Adem-O/OPTICA_MQ_LaserMaze/README.md

# OPTICA MQ Student Chapter - Laser Maze Project:
This repo contains the code and auxillary files for the MQ OPTICA Student Chapter laser maze.

Documentation on the setup and running of the laser maze can be found here: [PENDING]

The UI is run on the controller's Raspberry Pi using `LaserMazeController.py`. 
The schematic for the controller and Pi is found in `LaserMazeControllerSchematic.pdf`.

The associated i2c commands are stored in `opticamqfunclib.py`.

The arduinos which run the detectors and laser diodes have the `main_V8.ino` code saved to memory, this allows them to excute control functions on request (sent from the Pi via i2c). 
The schematic for the detector and arduino modules are found in  `LaserMazeDetectorsSchematic.pdf`
The encolsure schematics for the detectors is found in `LaserMaze_Detector_Enclosure.pdf`

## Credit <br>
**Enclosures and Design/Concept:** Dr Simon Gross, Associate Professor Faculty of Science and Engineering, Macquarie University<br> <br>
**Software Contributors:** Alan Tricoche ( Université Paris-Saclay), Elizabeth Arcadi (Macquarie University), James Bainbridge (Macquarie University), Adem Ozer (Macquarie University)<br> <br>
**Schematics Designed by:** Dr Russell Connally, Logic Systems Design <br> <br>

For any questions about the code/setup feel free to email: adem.ozer@hdr.mq.edu.au
