Adem-O/OPTICA_MQ_LaserMaze/LaserMazeDetectorsSchematic.pdf

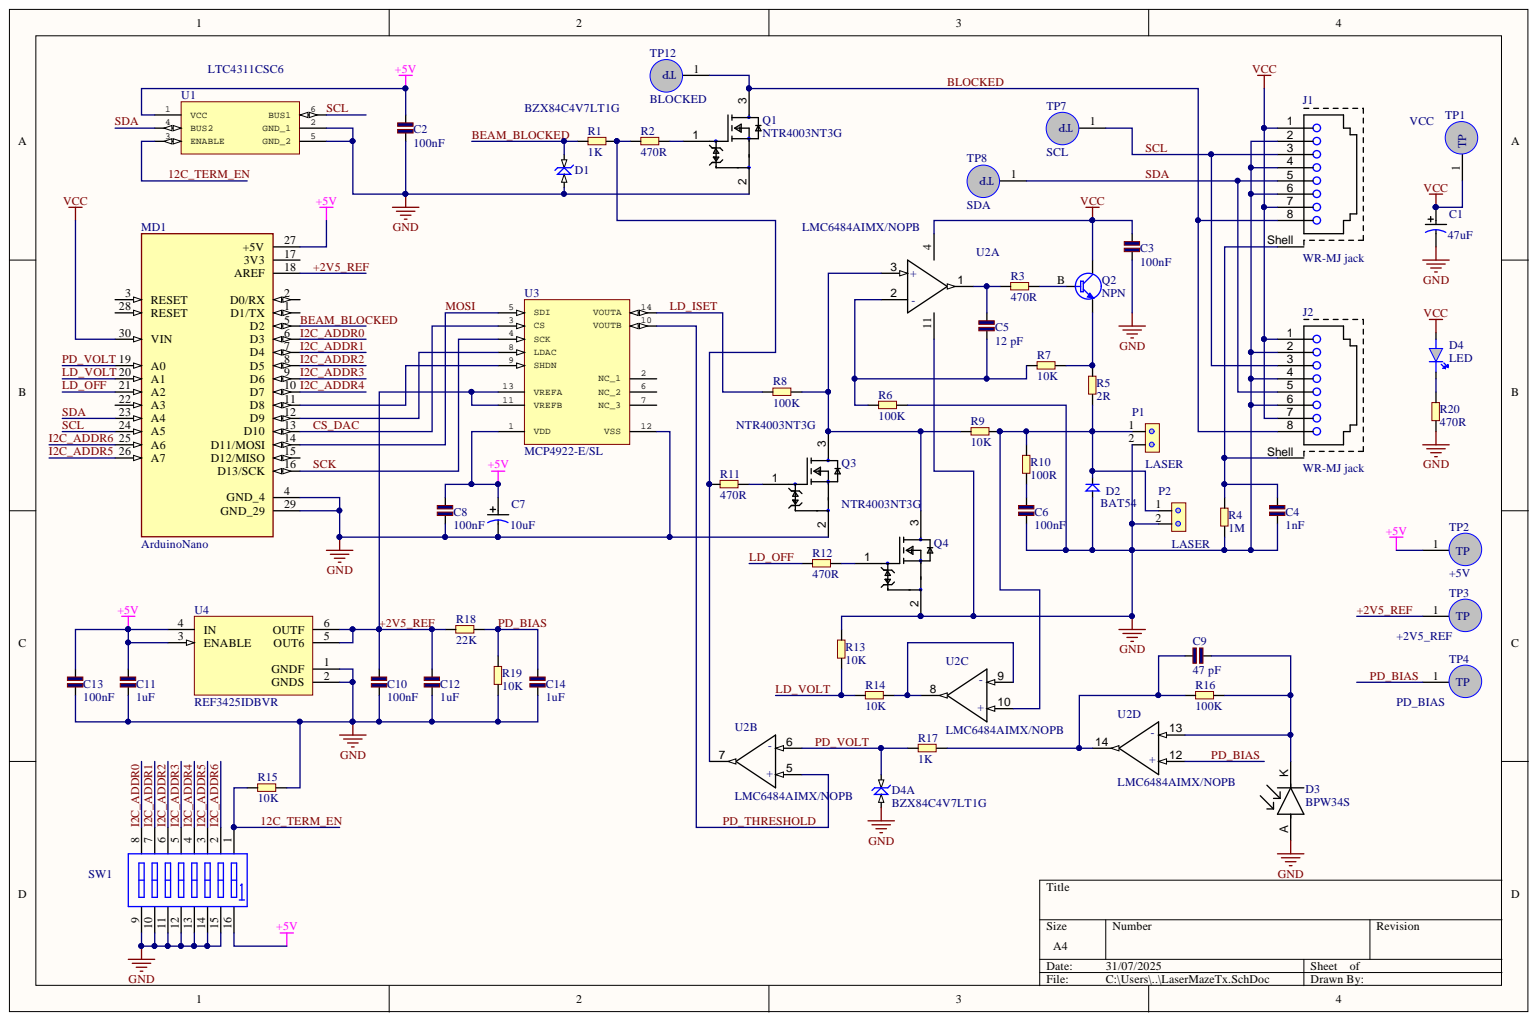
[picture p4: page 1]

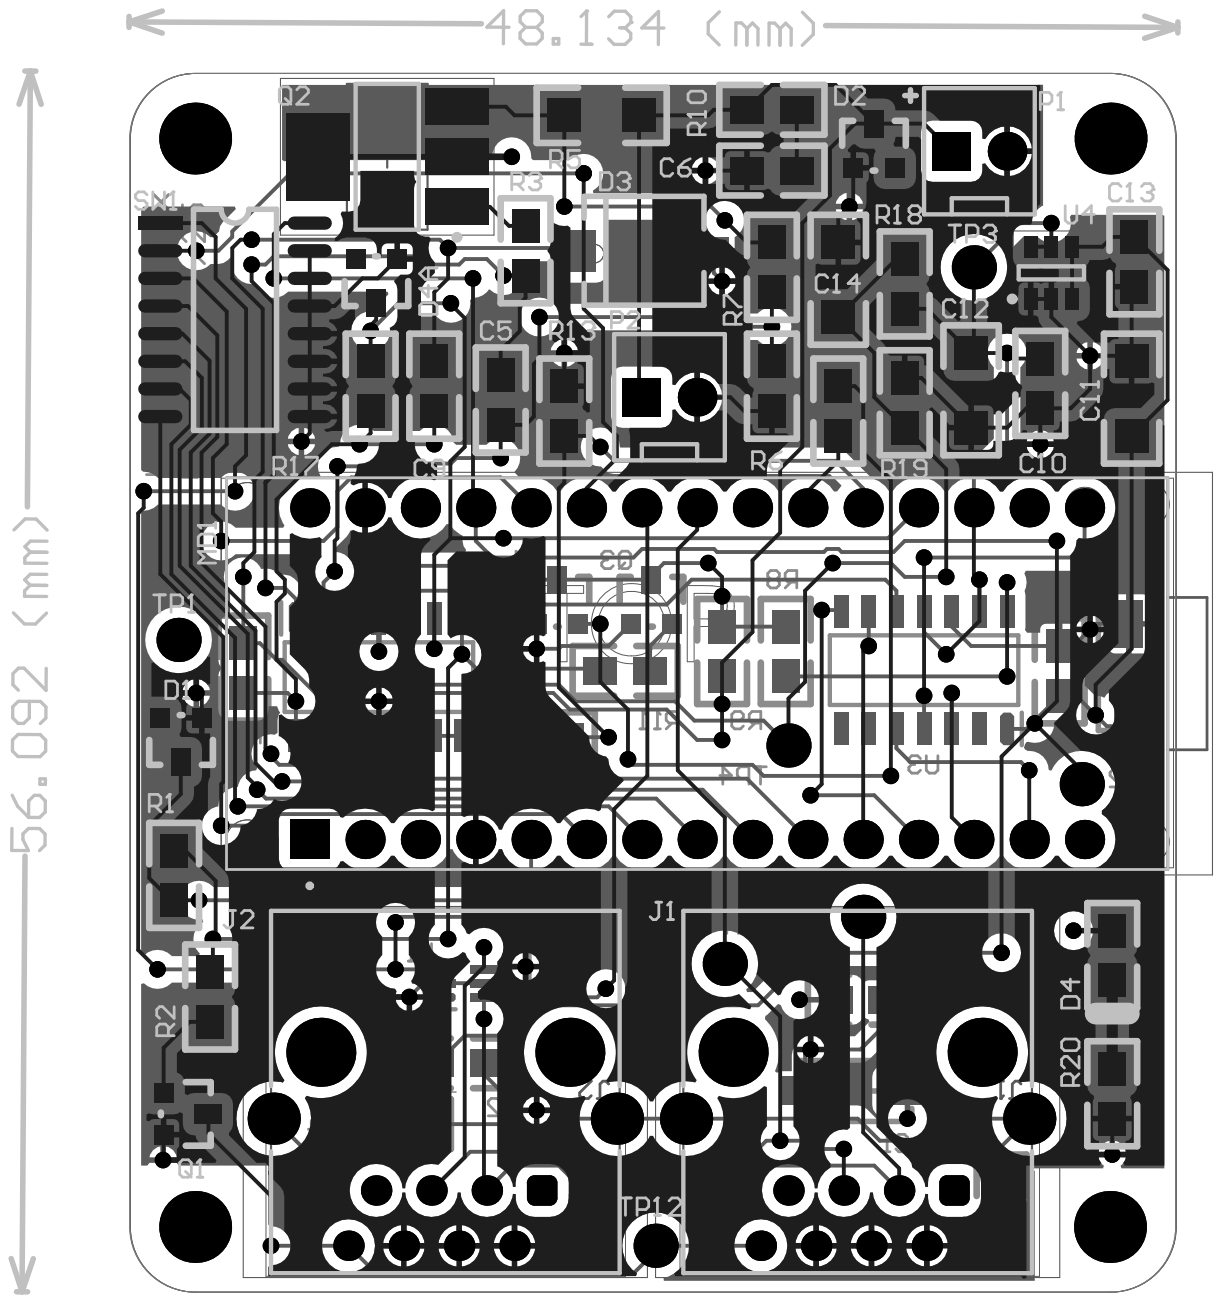
[picture p5: page 2]

# Board S
