Adem-O/OPTICA_MQ_LaserMaze/LaserMaze_Detector_Enclosure.pdf

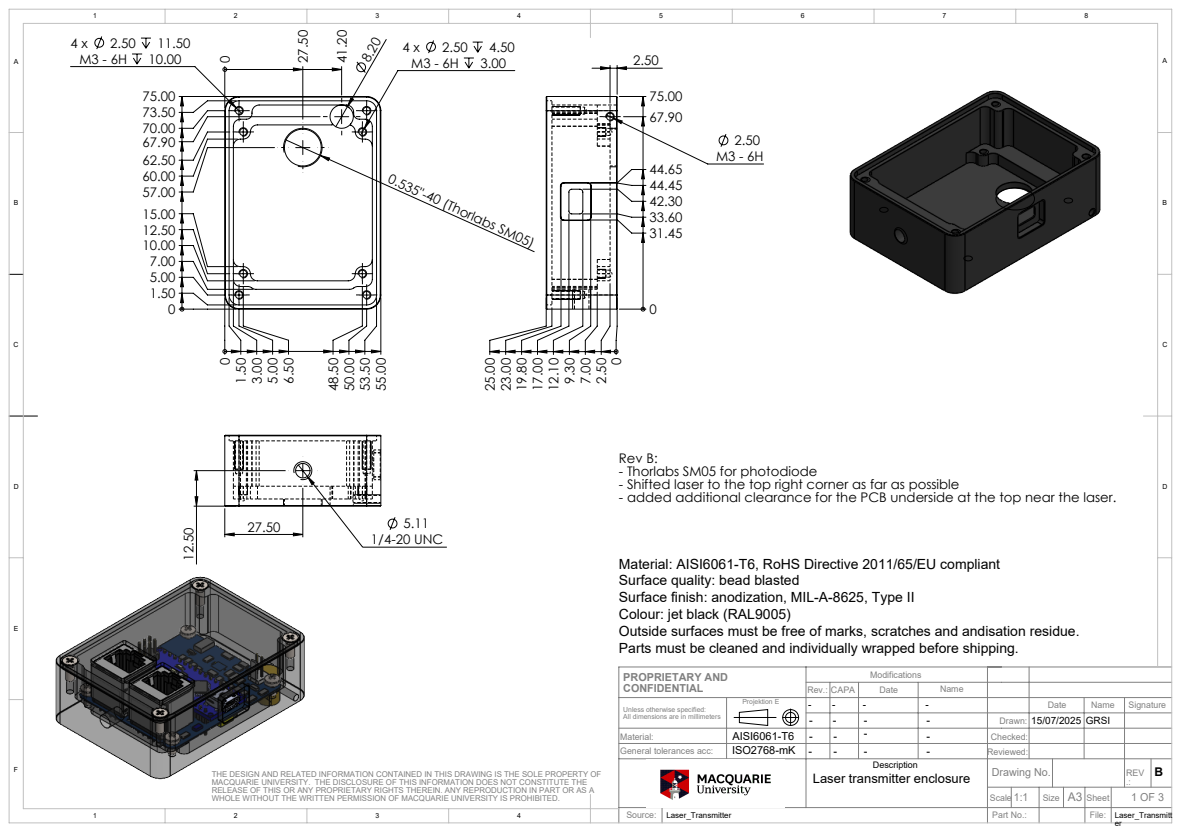
[picture p6: page 1]
0.535"-40 (Thorlabs SM05); 1/4-20 UNC; Part No.:; Laser_Transmitt; er File:

Rev B:
- Thorlabs SM05 for photodiode
- Shifted laser to the top right corner as far as possible
- added additional clearance for the PCB underside at the top near the laser.

Material: AISI6061-T6, RoHS Directive 2011/65/EU compliant
Surface quality: bead blasted
Surface finish: anodization, MIL-A-8625, Type II
Colour: jet black (RAL9005)
Outside surfaces must be free of marks, scratches and andisation residue.
Parts must be cleaned and individually wrapped before shipping.

PROPRIETARY AND CONFIDENTIAL | Modifications

Rev.: | CAPA | Date | Name

Unless otherwise specified: All dimensions are in millimeters | Projektion E | - | - | - | - | | Date | Name | Signature

- | - | - | - | Drawn: | 15/07/2025 | GRSI

Material: | AISI6061-T6 | - | - | - | - | Checked:
General tolerances acc: | ISO2768-mK | - | - | - | - | Reviewed:

Description Laser transmitter enclosure | Drawing No. | | REV .: | B

THE DESIGN AND RELATED INFORMATION CONTAINED IN THIS DRAWING IS THE SOLE PROPERTY OF
MACQUARIE UNIVERSITY. THE DISCLOSURE OF THIS INFORMATION DOES NOT CONSTITUTE THE
RELEASE OF THIS OR ANY PROPRIETARY RIGHTS THEREIN. ANY REPRODUCTION IN PART OR AS A
WHOLE WITHOUT THE WRITTEN PERMISSION OF MACQUARIE UNIVERSITY IS PROHIBITED.

Scale | 1:1 | Size | A3 | Sheet

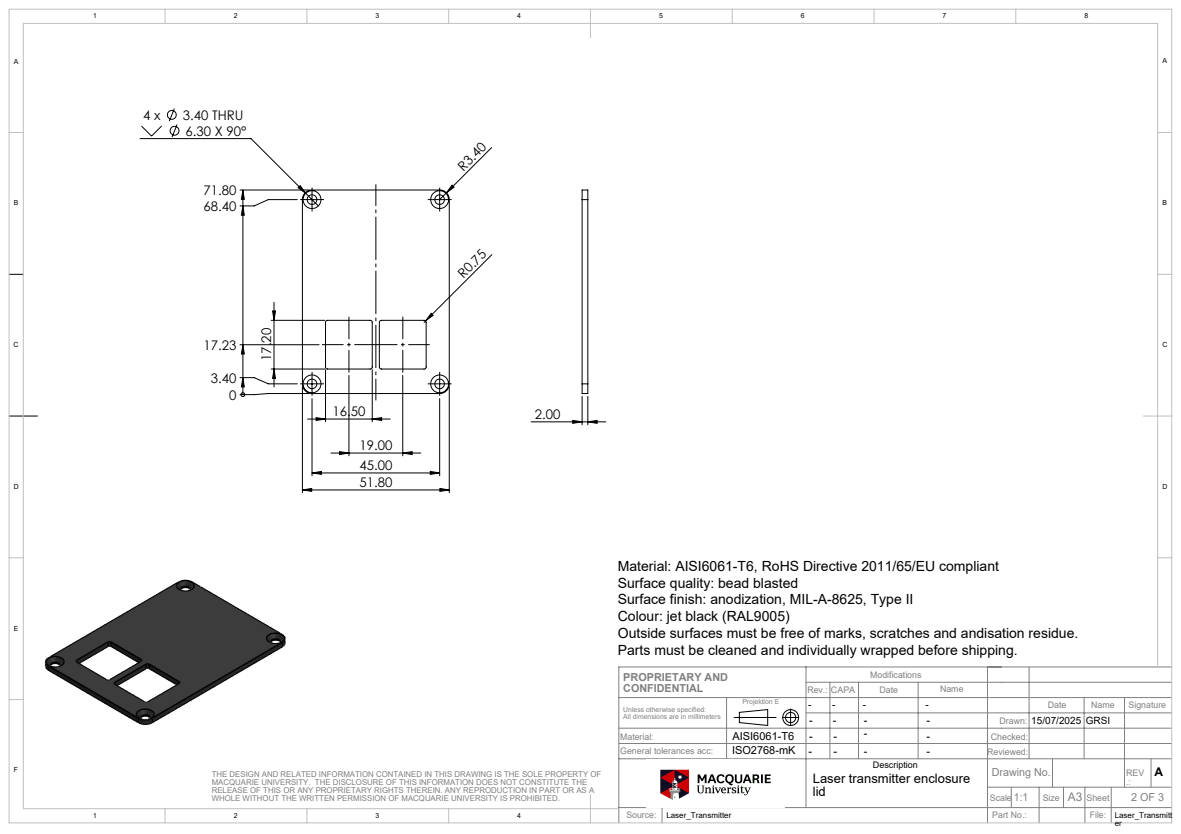
[picture p7: page 2]
3.40 THRU; Part No.:; Laser_Transmitt; er File:

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

PROPRIETARY AND CONFIDENTIAL | Modifications

Rev.: | CAPA | Date | Name

Unless otherwise specified: All dimensions are in millimeters | Projektion E | - | - | - | - | | Date | Name | Signature

- | - | - | - | Drawn: | 15/07/2025 | GRSI

Material: | AISI6061-T6 | - | - | - | - | Checked:
General tolerances acc: | ISO2768-mK | - | - | - | - | Reviewed:

Description Laser transmitter enclosure lid | Drawing No. | | REV .: | A

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

Scale | 1:1 | Size | A3 | Sheet
