Adem-O/OPTICA_MQ_LaserMaze/(commit log)

2025-08-09 arduino commands
2025-08-11 Update main_V4.ino
    Update the loop; the Arduino does nothing after it is plugged in.
2025-08-11 Update GUI_testing.py
    Turn off all lasers when exiting the app.
2025-08-11 Update main_V4.ino
    Return to the previous code because the Arduino is too slow to turn off the laser with the current code
2025-08-11 Update main_V4.ino
    The Arduino does nothing when it doesn’t receive a command
2025-08-29 New arduino code for extra pins
    Added extra pins for increasing dipswitches connected to arduino controllers
2025-08-29 New analogue pin config
2025-09-05 Schematics for controller and modules
2025-09-05 Adjust starting address for I2C bus scan
2025-09-18 GUI Ver. 1.3.5, Arduino Ver. 6
2025-11-06 Latest arduino code with modified thresholding
    This is the EA update which enables the Arduino to dynamically set the threshold for the PD so that it will operate under dynamic conditions (i.e with smoke)
2025-11-10 Update README with project details and file references
    Expanded project description with details on UI, commands, and schematics.
2025-11-10 Update README with enclosure schematic information
    Added enclosure schematic for detectors.
